Greyd0ve/lm317-digital-power-supply/docs/照片/带负载测试.jpg

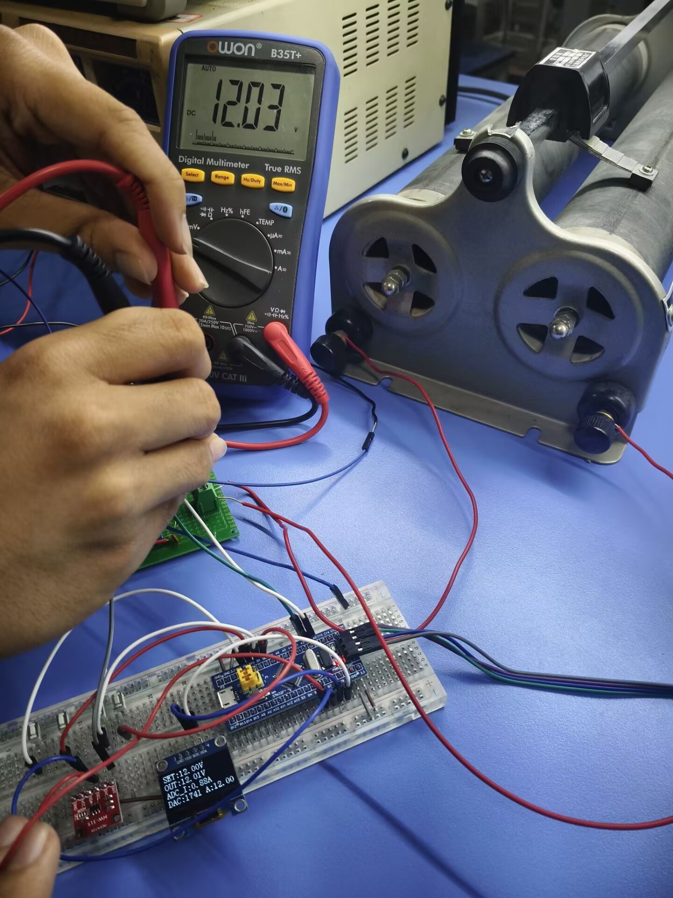
docs/照片/带负载测试.jpg
