Greyd0ve/lm317-digital-power-supply/docs/照片/PID调参效果曲线.jpg

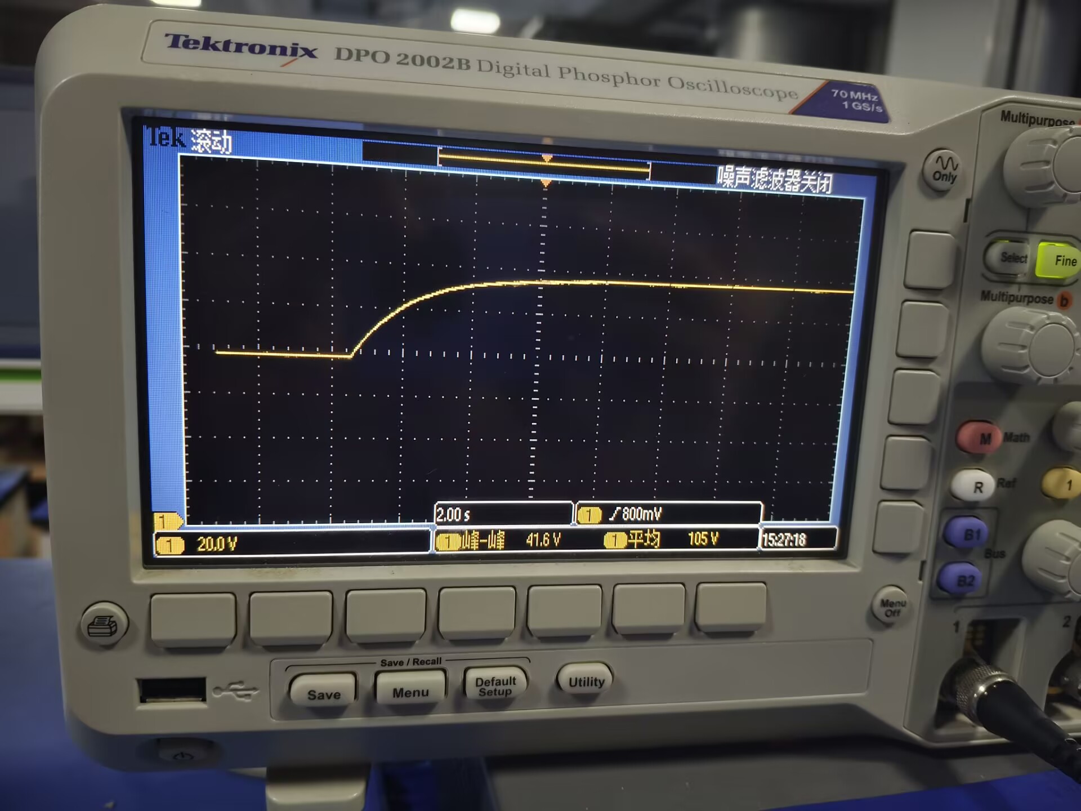
docs/照片/PID调参效果曲线.jpg
