Greyd0ve/lm317-digital-power-supply/docs/照片/仿真测试图片.png

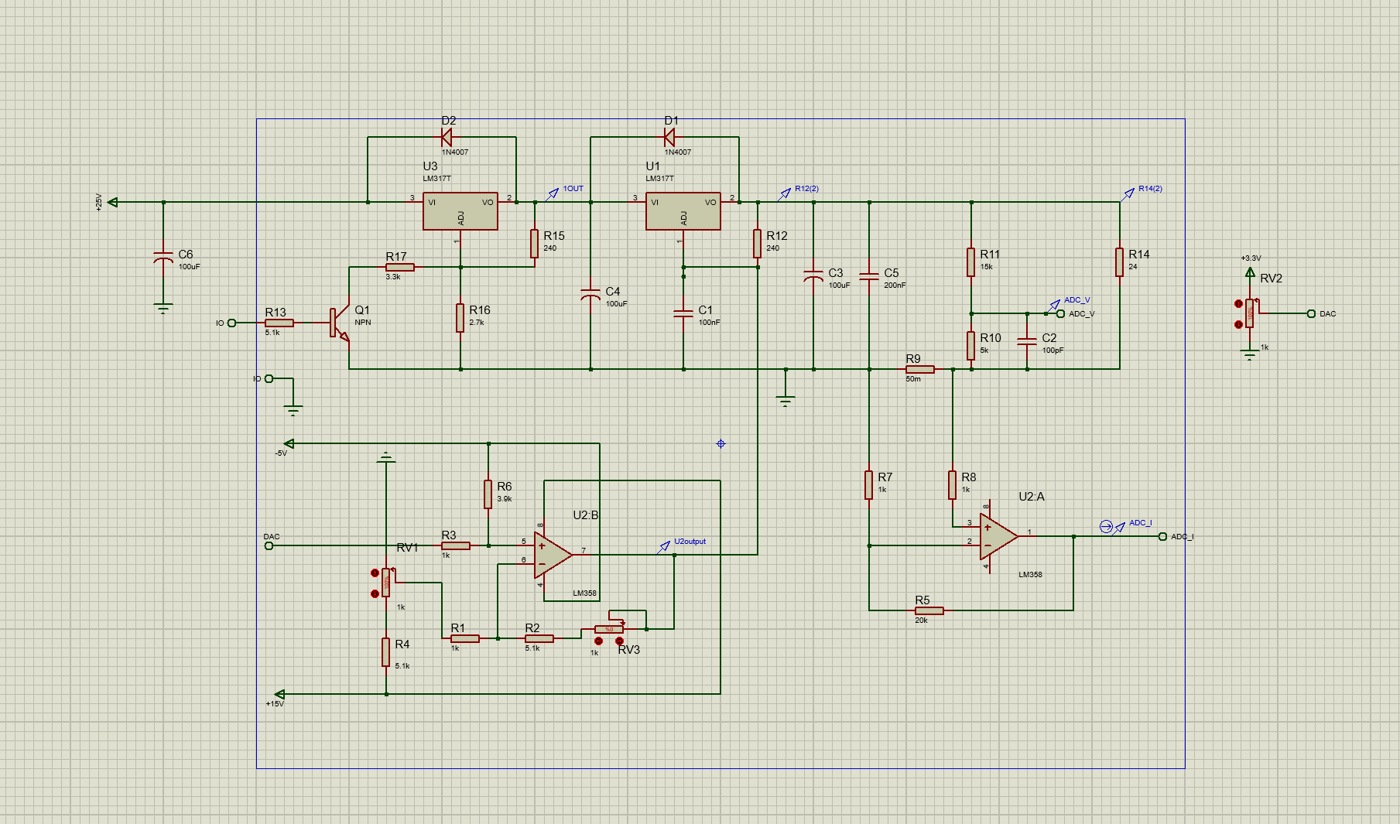
docs/照片/仿真测试图片.png
