Greyd0ve/lm317-digital-power-supply/docs/照片/实验照片.jpg

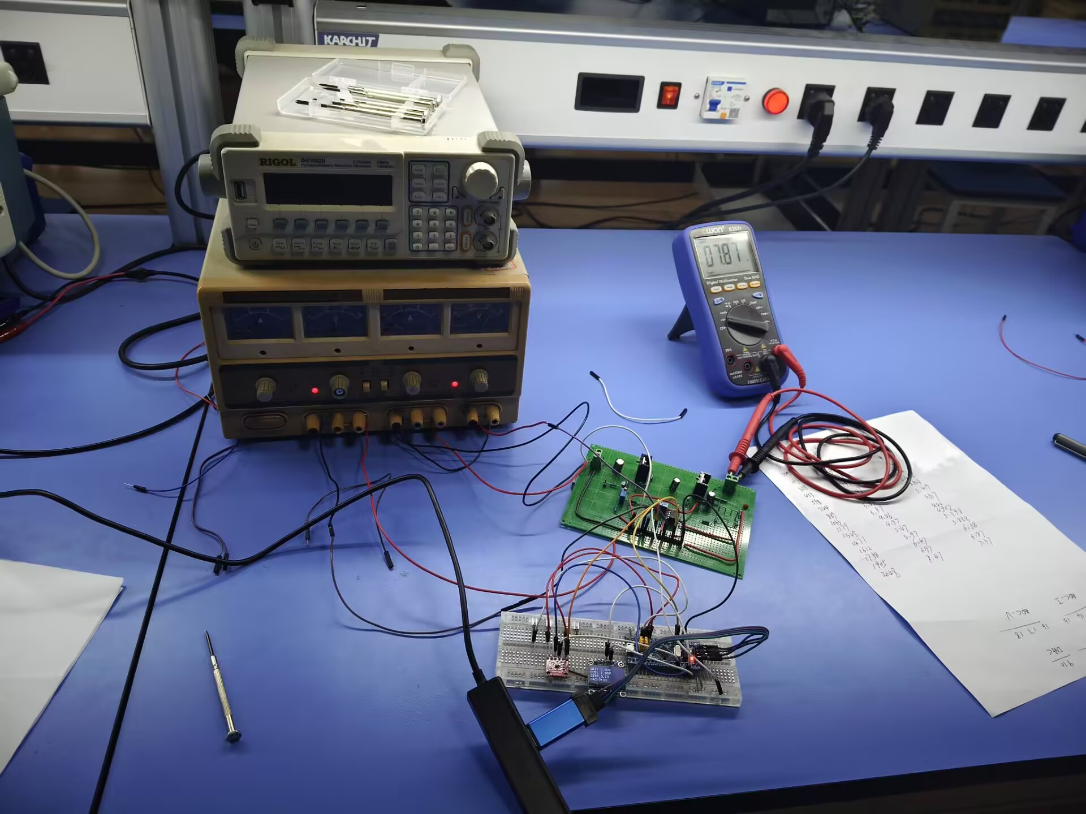
docs/照片/实验照片.jpg
