Greyd0ve/lm317-digital-power-supply/docs/照片/洞洞板照片-背面.jpg

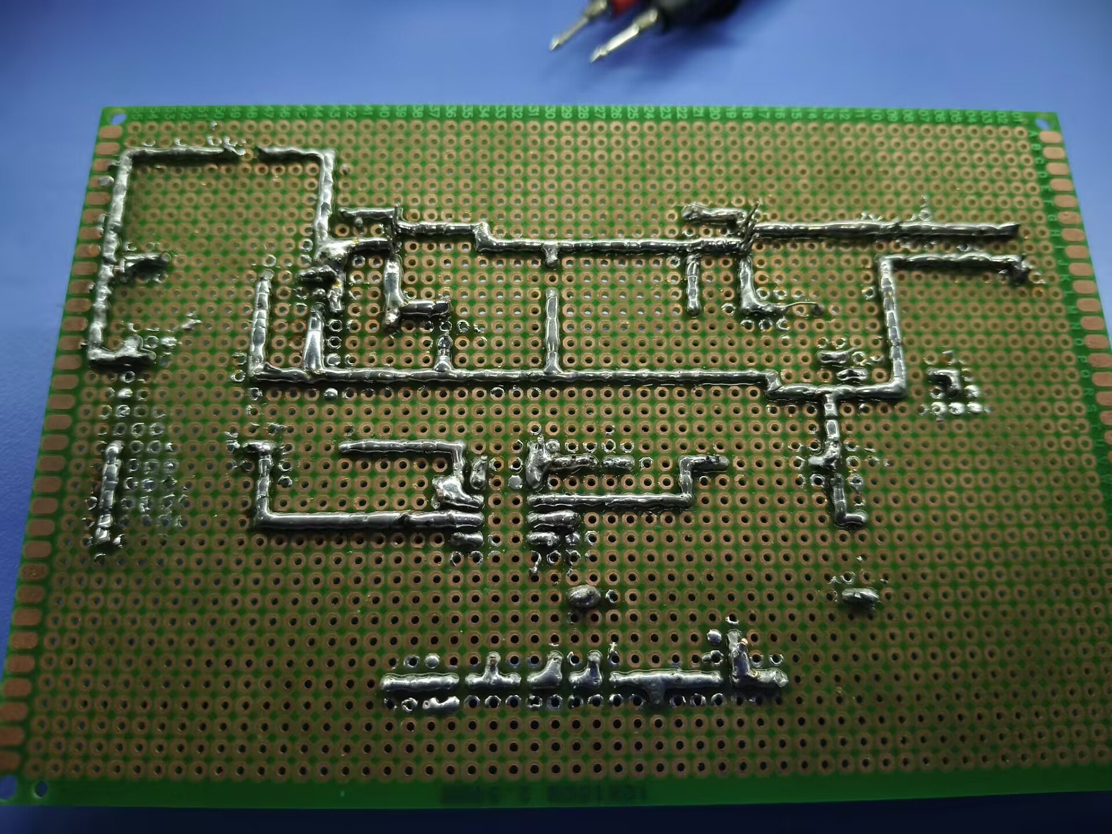
docs/照片/洞洞板照片-背面.jpg
