Greyd0ve/lm317-digital-power-supply/firmware/LM317降压联调验证版 - 非线性拟合电压输出-PID控制/Hardware/AD.c

#include "stm32f10x.h"
#include "AD.h"

void AD_Init(void)
{
	GPIO_InitTypeDef GPIO_InitStructure;
	ADC_InitTypeDef ADC_InitStructure;

	/* 开启时钟 */
	RCC_APB2PeriphClockCmd(RCC_APB2Periph_ADC1, ENABLE);
	RCC_APB2PeriphClockCmd(RCC_APB2Periph_GPIOA, ENABLE);

	/* ADC时钟 = 72MHz / 6 = 12MHz */
	RCC_ADCCLKConfig(RCC_PCLK2_Div6);

	/* PA0, PA1 作为模拟输入 */
	GPIO_InitStructure.GPIO_Mode = GPIO_Mode_AIN;
	GPIO_InitStructure.GPIO_Pin = GPIO_Pin_0 | GPIO_Pin_1;
	GPIO_InitStructure.GPIO_Speed = GPIO_Speed_50MHz;
	GPIO_Init(GPIOA, &GPIO_InitStructure);

	ADC_InitStructure.ADC_Mode = ADC_Mode_Independent;
	ADC_InitStructure.ADC_DataAlign = ADC_DataAlign_Right;
	ADC_InitStructure.ADC_ExternalTrigConv = ADC_ExternalTrigConv_None;
	ADC_InitStructure.ADC_ContinuousConvMode = DISABLE;
	ADC_InitStructure.ADC_ScanConvMode = DISABLE;
	ADC_InitStructure.ADC_NbrOfChannel = 1;
	ADC_Init(ADC1, &ADC_InitStructure);

	ADC_Cmd(ADC1, ENABLE);

	ADC_ResetCalibration(ADC1);
	while (ADC_GetResetCalibrationStatus(ADC1) == SET);

	ADC_StartCalibration(ADC1);
	while (ADC_GetCalibrationStatus(ADC1) == SET);
}

uint16_t AD_GetValue(uint8_t ADC_Channel)
{
	ADC_RegularChannelConfig(ADC1, ADC_Channel, 1, ADC_SampleTime_239Cycles5);
	ADC_SoftwareStartConvCmd(ADC1, ENABLE);

	while (ADC_GetFlagStatus(ADC1, ADC_FLAG_EOC) == RESET);

	return ADC_GetConversionValue(ADC1);
}

uint16_t AD_GetAverage(uint8_t ADC_Channel, uint8_t Count)
{
	uint8_t i;
	uint32_t Sum = 0;

	for (i = 0; i < Count; i++)
	{
		Sum += AD_GetValue(ADC_Channel);
	}

	return (uint16_t)(Sum / Count);
}
