Greyd0ve/lm317-digital-power-supply/(commit log)

2026-04-16 Initial commit: LM317 digital power supply project
2026-04-19 优化按键，新增确认按键，调节单片机DAC输出的方式改为增量式PID控制输出
2026-04-19 新增一些实验结果测试照片
2026-04-20 新增仿真测试图片
